prajwalShanthakumar/RobotNavigation_BehavioralControl_2014/118.JPG

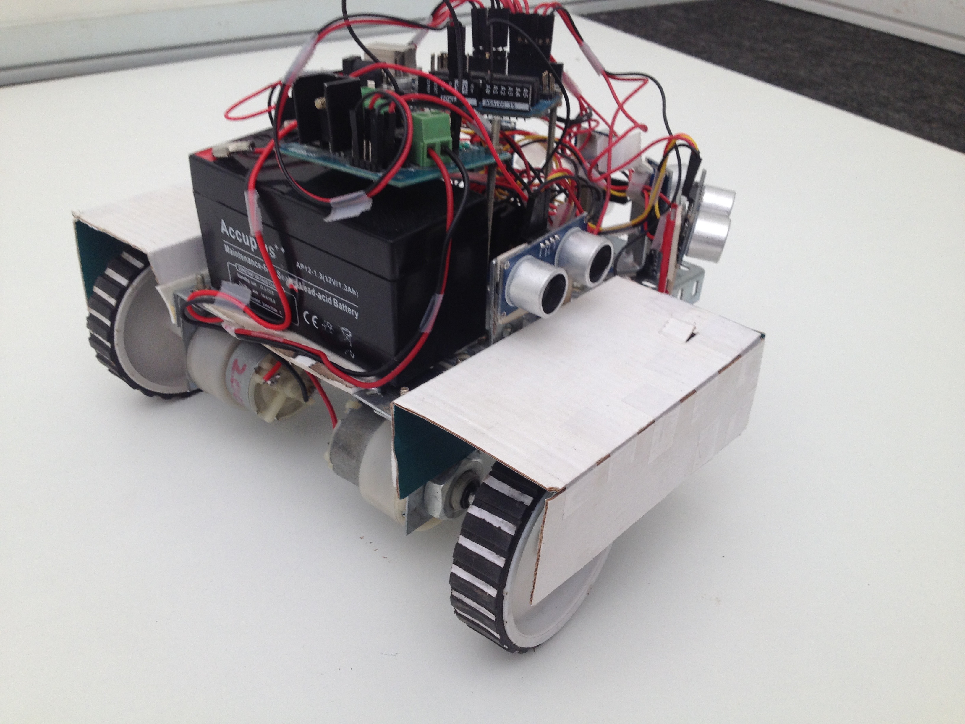
118.JPG
