prajwalShanthakumar/RobotNavigation_BehavioralControl_2014/117.JPG

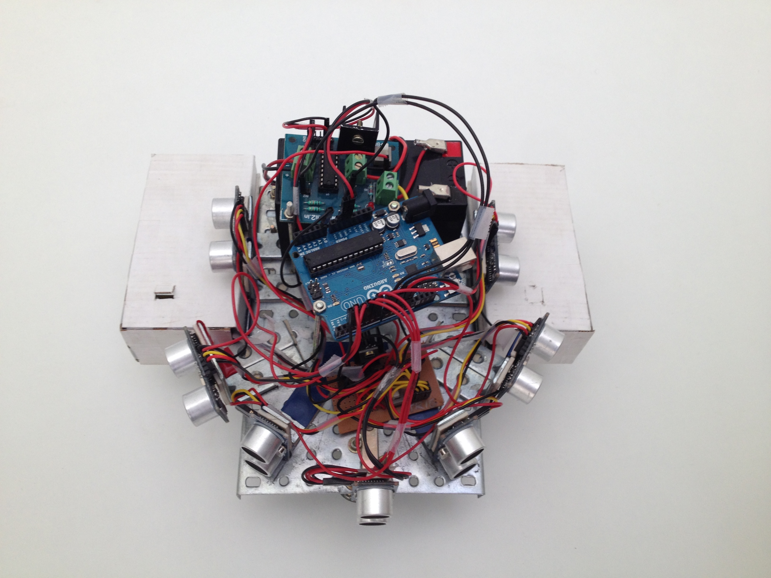
117.JPG
